diyjack/portapack/portapack_hackrf/hardware/portapack_hackrf_one/case/pp_h1_case.png

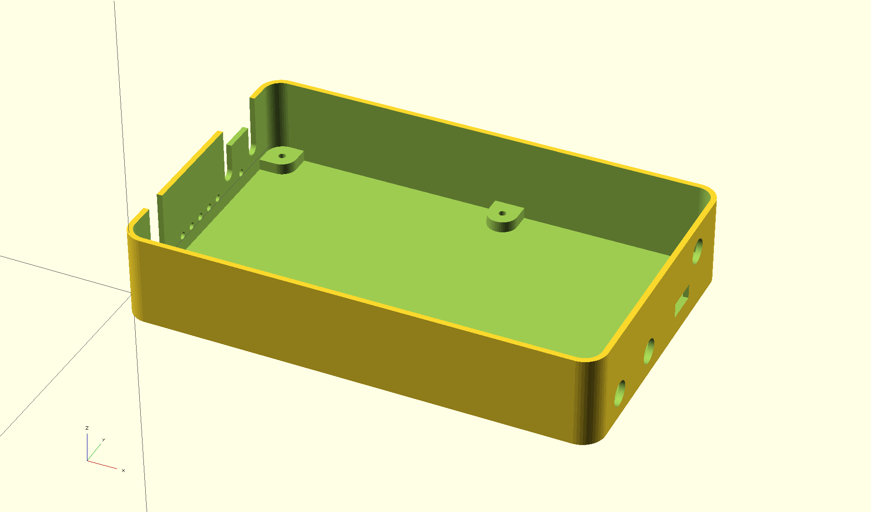
portapack_hackrf/hardware/portapack_hackrf_one/case/pp_h1_case.png
