diyjack/portapack/portapack_hackrf/hardware/portapack_hackrf_one/case/pp_h1_case.stl

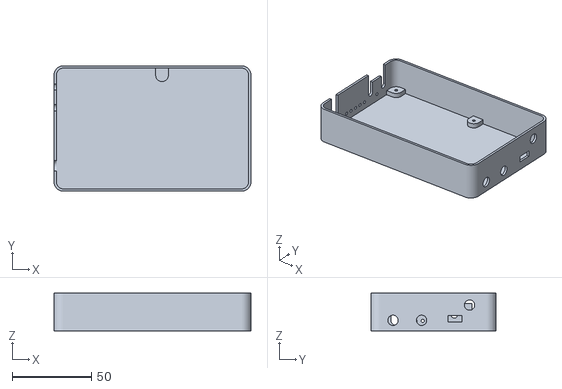
[picture p12: CAD file, 2014-07-30]
portapack_hackrf/hardware/portapack_hackrf_one/case/pp_h1_case.stl
124.0 x 79.0 x 23.7
