diyjack/portapack/portapack_hackrf/hardware/portapack_hackrf_one/portapack_hackrf_one.pdf

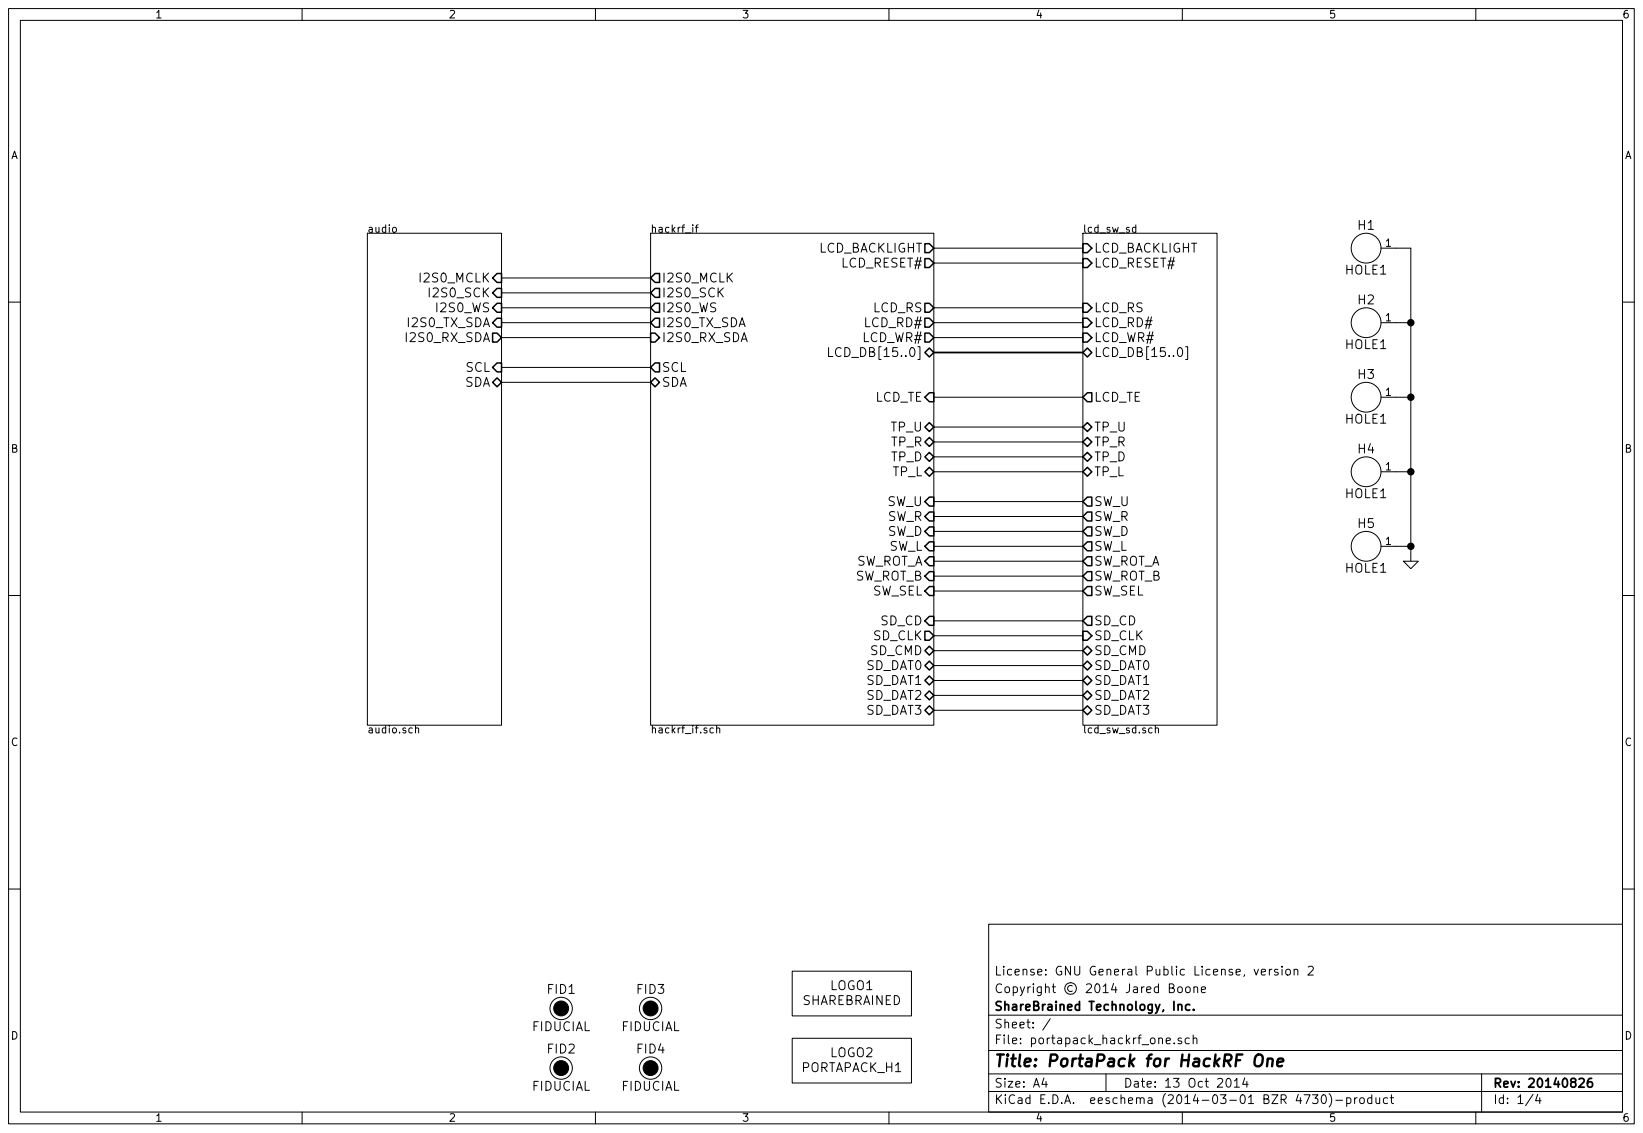
[picture p13: page 1]

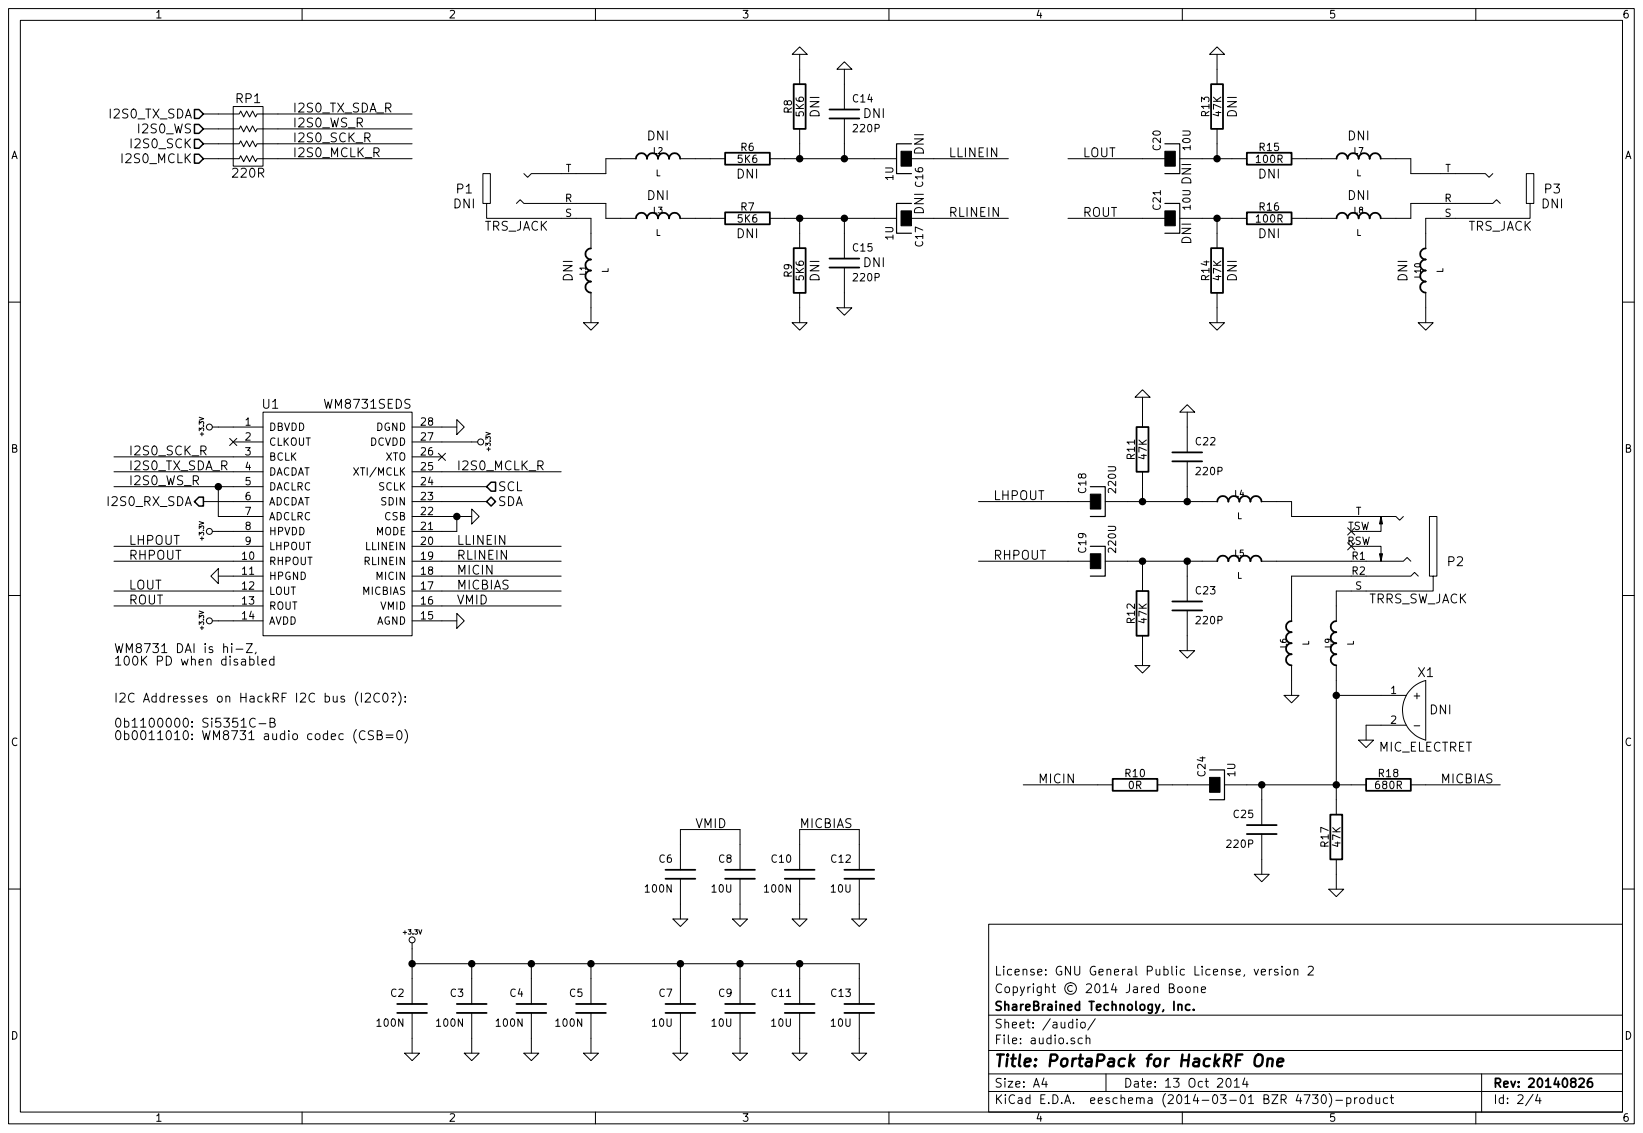
[picture p14: page 2]

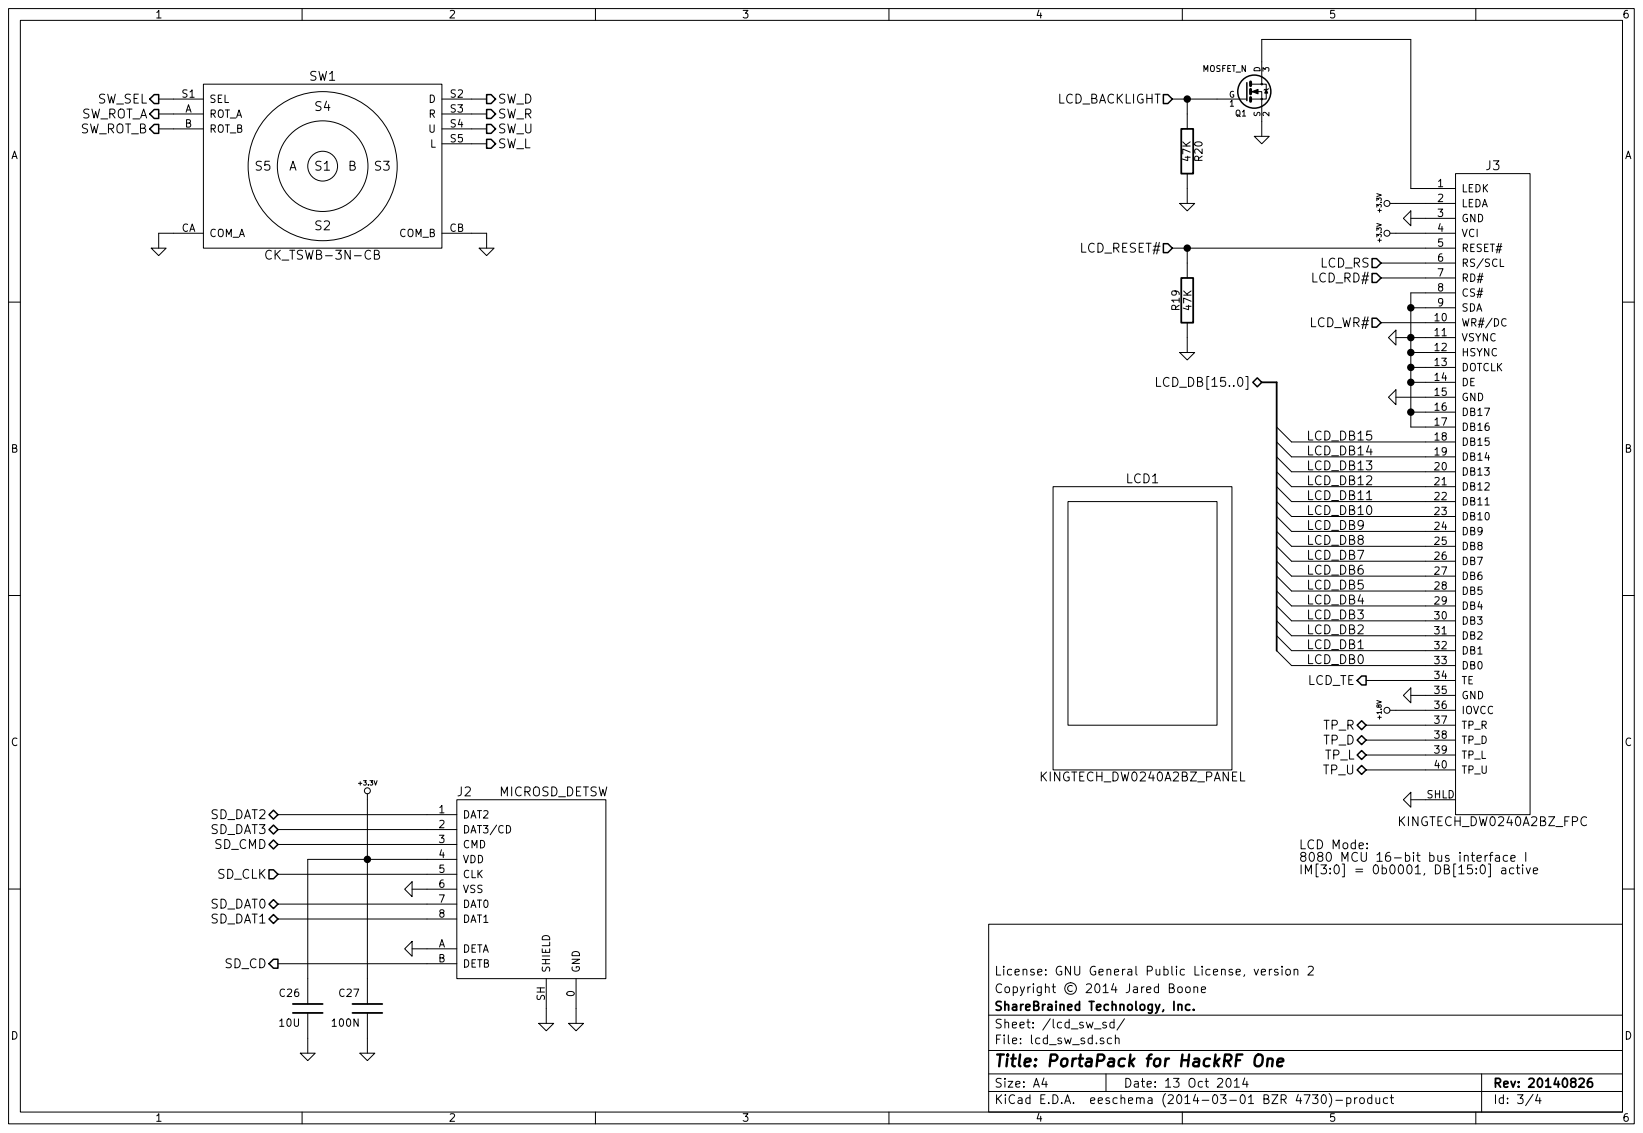
[picture p15: page 3]

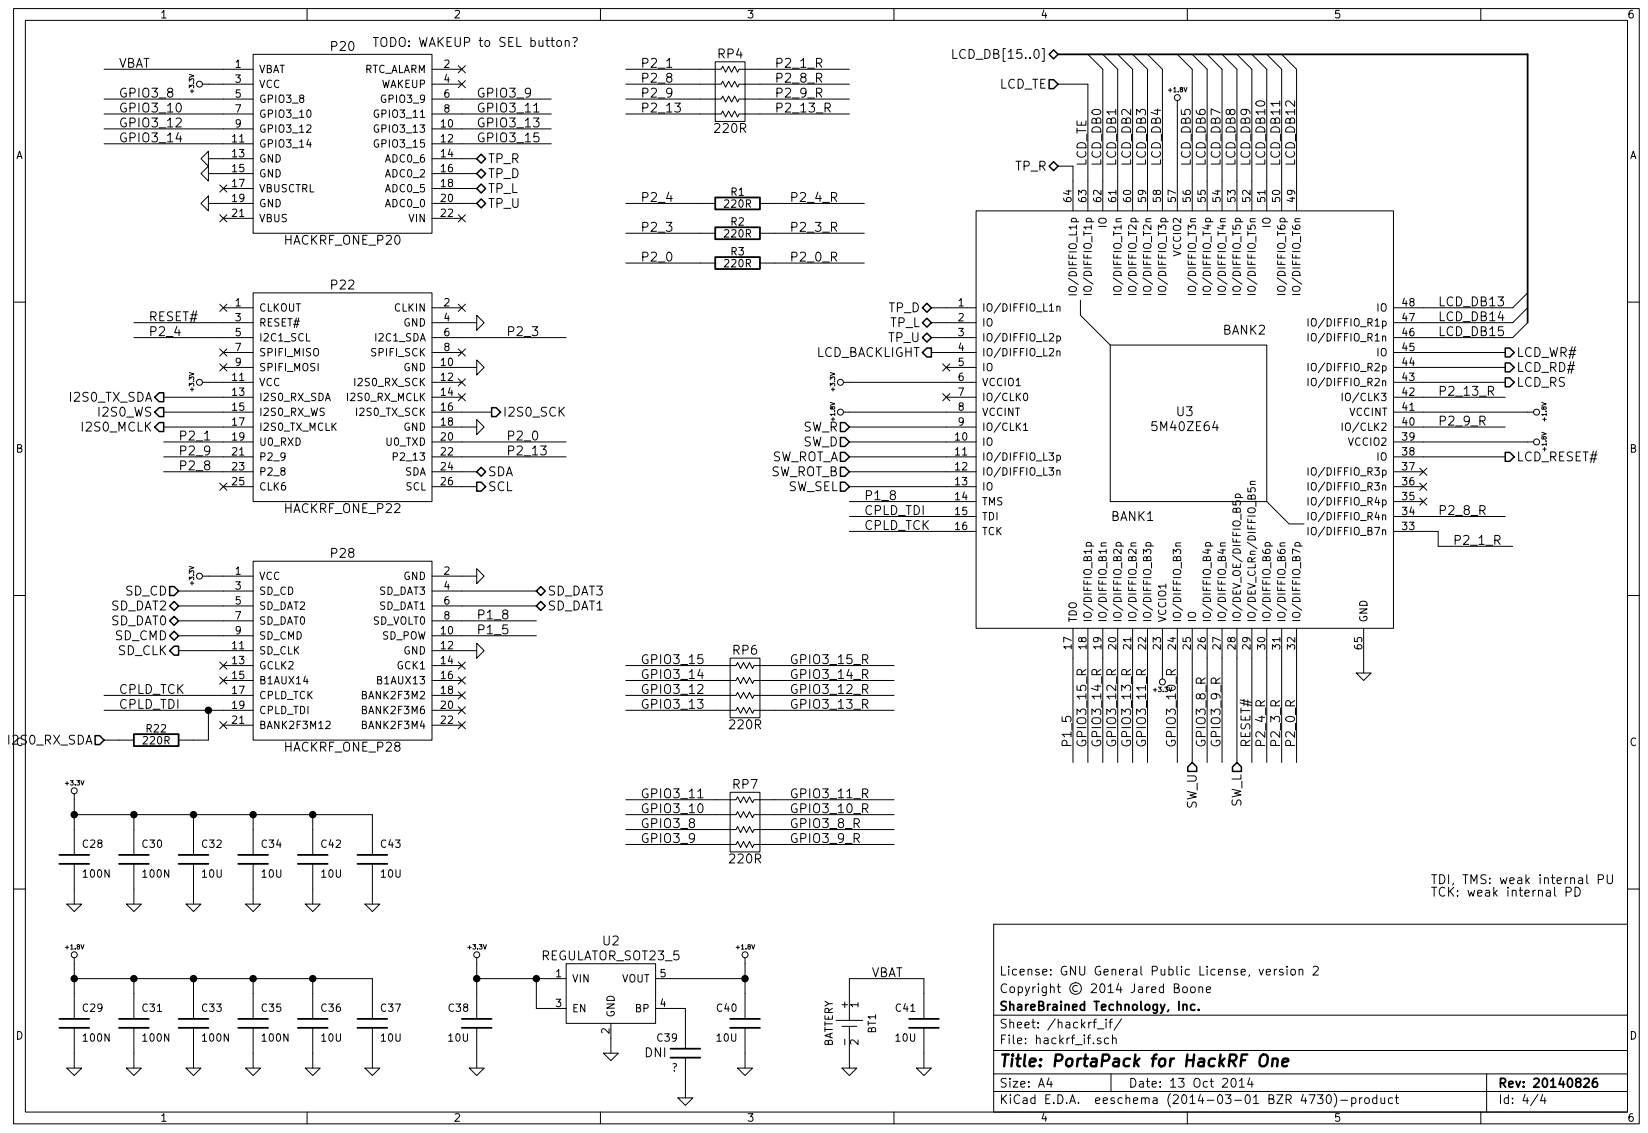
[picture p16: page 4]
