diyjack/portapack/portapack_hackrf/hardware/portapack_hackrf_one/portapack_hackrf_one.kicad_pcb

## KiCad design portapack_hackrf/hardware/portapack_hackrf_one/portapack_hackrf_one.kicad_pcb (2014-10-13)

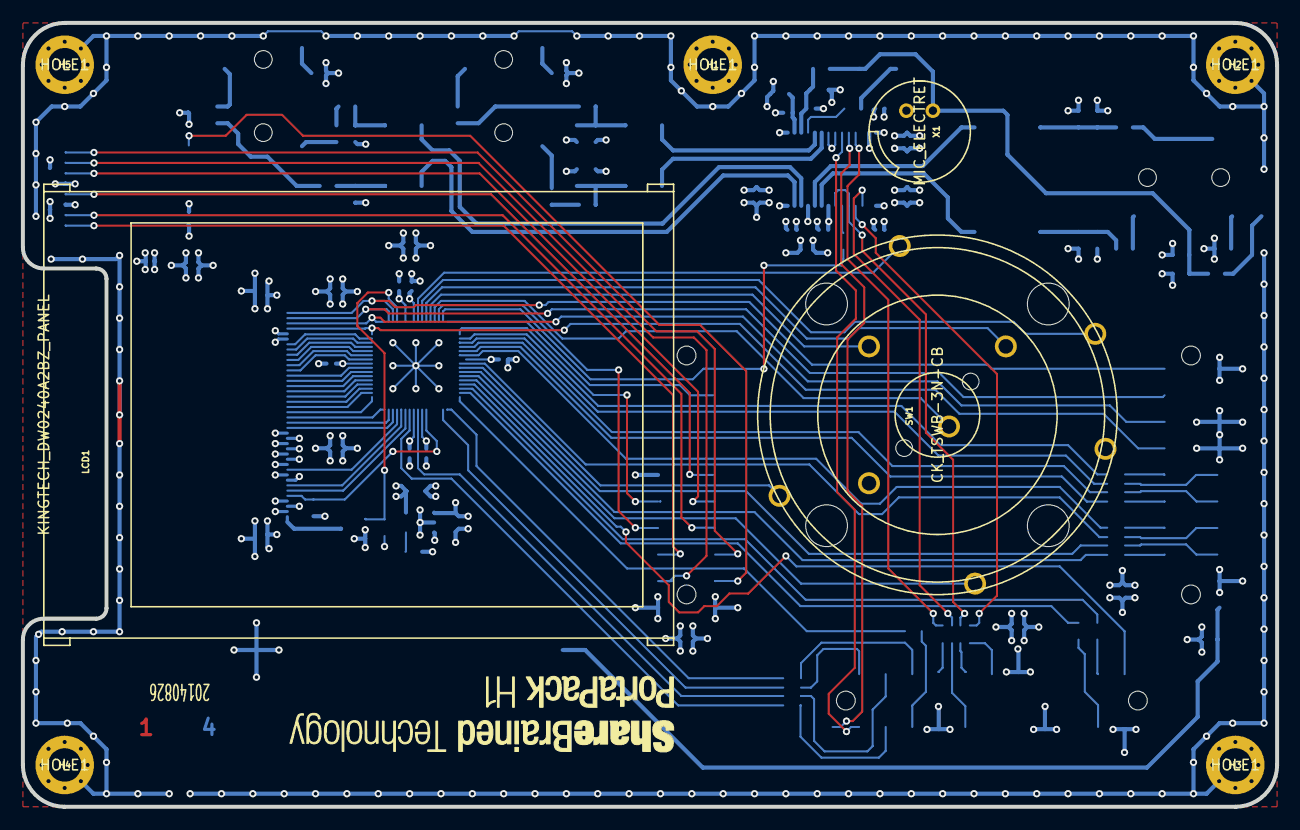
[picture p17: board portapack_hackrf_one.kicad_pcb from above]

Board: 4 copper layers, 120.0 x 75.0 mm, 102 parts (0 on the bottom side), 123 nets.

Parts:
BT1: BATTERY; MPD_BU2032SM-BT-G
C2, C3, C4, C5, C6, C10, C27, C28, C29, C30, C31, C33, C35: 100N; IPC_CAPC1005X55N
C7, C8, C9, C11, C12, C13, C26, C32, C34, C36, C37, C38, C40, C41, C42, C43: 10U; IPC_CAPC2012X140N
C14, C15, C22, C23, C25: 220P; IPC_CAPC1608X95N
C16, C17, C24: 1U; IPC_CAPAE430X540N
C18, C19: 220U; IPC_CAPAE830X620N
C20, C21: 10U; IPC_CAPAE430X540N
C39: DNI; IPC_CAPC1608X90N
FID1, FID2, FID3, FID4: FIDUCIAL; FIDUCIAL_65MIL
H1, H2, H3, H4, H5: HOLE1; HOLE_3200UM_VIAS
J2: MICROSD_DETSW; ALPS_SCHA4B0100
J3: KINGTECH_DW0240A2BZ_FPC; MOLEX_54132-40XX_LR
L1, L2, L3, L4, L5, L6, L7, L8, L9, L10: L; IPC_INDC1608X95N
LCD1: KINGTECH_DW0240A2BZ_PANEL
LOGO1: SHAREBRAINED; sharebrained_text_300
LOGO2: PORTAPACK_H1; portapack_text_300
P1, P3: TRS_JACK; CUI_SJ-3524-SMT
P2: TRRS_SW_JACK; CUI_SJ-43516-SMT
P20: HACKRF_ONE_P20; HEADER_11X2_REV_SM_254_AP
P22: HACKRF_ONE_P22; HEADER_13X2_REV_SM_254_AP
P28: HACKRF_ONE_P28; HEADER_11X2_REV_SM_254_AP
Q1: MOSFET_N; IPC_SOT95P230X110-3N
R1, R2, R3, R22: 220R; IPC_RESC1608X55N
R6, R7, R8, R9: 5K6; IPC_RESC1608X55N
R10, R11, R12, R13, R14, R17, R19, R20: 47K; IPC_RESC1608X55N
R15, R16: 100R; IPC_RESC1608X55N
R18: 680R; IPC_RESC1608X55N
RP1, RP4, RP6, RP7: 220R; IPC_RESCAXS80P160X320X60-8N
SW1: CK_TSWB-3N-CB; CK_TSWB-3N-CB222_LFS
U1: WM8731SEDS; IPC_SOP65P780X200-28N
U2: REGULATOR_SOT23_5; IPC_SOT95P280X110-5N
U3: 5M40ZE64; IPC_QFP40P900X900X120-65N
X1: MIC_ELECTRET; CUI_CMA-4544PF-W

Connections:
+1.8V: C29.1, C31.1, C33.1, C35.1, C36.1, C37.1, C40.1, J3.36, U2.5, U3.8, U3.39, U3.41, U3.57
+3.3V: C2.1, C3.1, C4.1, C5.1, C7.1, C9.1, C11.1, C13.1, C26.1, C27.1, C28.1, C30.1, C32.1, C34.1, C38.1, C42.1, C43.1, J2.4, J3.2, J3.4, P20.3, P22.11, P28.1, U1.1, U1.8, U1.14, U1.27, U2.1, U2.3, U3.6, U3.23
/audio/I2S0_MCLK: P22.17, RP1.4
/audio/I2S0_MCLK_R: RP1.5, U1.25
/audio/I2S0_RX_SDA: R22.2, U1.6
/audio/I2S0_SCK: P22.16, RP1.3
/audio/I2S0_SCK_R: RP1.6, U1.3
/audio/I2S0_TX_SDA: P22.13, RP1.1
/audio/I2S0_TX_SDA_R: RP1.8, U1.4
/audio/I2S0_WS: P22.15, RP1.2
/audio/I2S0_WS_R: RP1.7, U1.5, U1.7
/audio/LHPOUT: C18.1, U1.9
/audio/LLINEIN: C16.1, U1.20
/audio/LOUT: C20.1, U1.12
/audio/MICBIAS: C10.1, C12.1, R18.1, U1.17
/audio/MICIN: R10.2, U1.18
/audio/RHPOUT: C19.1, U1.10
/audio/RLINEIN: C17.1, U1.19
/audio/ROUT: C21.1, U1.13
/audio/SCL: P22.26, U1.24
/audio/SDA: P22.24, U1.23
/audio/VMID: C6.1, C8.1, U1.16
/hackrf_if/CPLD_TCK: P28.17, U3.16
/hackrf_if/CPLD_TDI: P28.19, R22.1, U3.15
/hackrf_if/GPIO3_8: P20.5, RP7.3
/hackrf_if/GPIO3_8_R: RP7.6, U3.26
/hackrf_if/GPIO3_9: P20.6, RP7.4
/hackrf_if/GPIO3_9_R: RP7.5, U3.27
/hackrf_if/GPIO3_10: P20.7, RP7.2
/hackrf_if/GPIO3_10_R: RP7.7, U3.24
/hackrf_if/GPIO3_11: P20.8, RP7.1
/hackrf_if/GPIO3_11_R: RP7.8, U3.22
/hackrf_if/GPIO3_12: P20.9, RP6.3
/hackrf_if/GPIO3_12_R: RP6.6, U3.20
/hackrf_if/GPIO3_13: P20.10, RP6.4
/hackrf_if/GPIO3_13_R: RP6.5, U3.21
/hackrf_if/GPIO3_14: P20.11, RP6.2
/hackrf_if/GPIO3_14_R: RP6.7, U3.19
/hackrf_if/GPIO3_15: P20.12, RP6.1
/hackrf_if/GPIO3_15_R: RP6.8, U3.18
/hackrf_if/LCD_BACKLIGHT: Q1.1, R20.2, U3.4
/hackrf_if/LCD_DB0: J3.33, U3.62
/hackrf_if/LCD_DB1: J3.32, U3.61
/hackrf_if/LCD_DB2: J3.31, U3.60
/hackrf_if/LCD_DB3: J3.30, U3.59
/hackrf_if/LCD_DB4: J3.29, U3.58
/hackrf_if/LCD_DB5: J3.28, U3.56
/hackrf_if/LCD_DB6: J3.27, U3.55
/hackrf_if/LCD_DB7: J3.26, U3.54
/hackrf_if/LCD_DB8: J3.25, U3.53
/hackrf_if/LCD_DB9: J3.24, U3.52
/hackrf_if/LCD_DB10: J3.23, U3.51
/hackrf_if/LCD_DB11: J3.22, U3.50
/hackrf_if/LCD_DB12: J3.21, U3.49
/hackrf_if/LCD_DB13: J3.20, U3.48
/hackrf_if/LCD_DB14: J3.19, U3.47
/hackrf_if/LCD_DB15: J3.18, U3.46
/hackrf_if/LCD_RD#: J3.7, U3.44
/hackrf_if/LCD_RESET#: J3.5, R19.1, U3.38
/hackrf_if/LCD_RS: J3.6, U3.43
/hackrf_if/LCD_TE: J3.34, U3.63
/hackrf_if/LCD_WR#: J3.10, U3.45
/hackrf_if/P1_5: P28.10, U3.17
/hackrf_if/P1_8: P28.8, U3.14
/hackrf_if/P2_0: P22.20, R3.2
/hackrf_if/P2_0_R: R3.1, U3.32
/hackrf_if/P2_1: P22.19, RP4.1
/hackrf_if/P2_1_R: RP4.8, U3.33
/hackrf_if/P2_3: P22.6, R2.2
/hackrf_if/P2_3_R: R2.1, U3.31
/hackrf_if/P2_4: P22.5, R1.2
/hackrf_if/P2_4_R: R1.1, U3.30
/hackrf_if/P2_8: P22.23, RP4.2
/hackrf_if/P2_8_R: RP4.7, U3.34
/hackrf_if/P2_9: P22.21, RP4.3
/hackrf_if/P2_9_R: RP4.6, U3.40
/hackrf_if/P2_13: P22.22, RP4.4
/hackrf_if/P2_13_R: RP4.5, U3.42
/hackrf_if/RESET#: P22.3, U3.29
/hackrf_if/SD_CD: J2.B, P28.3
/hackrf_if/SD_CLK: J2.5, P28.11
/hackrf_if/SD_CMD: J2.3, P28.9
/hackrf_if/SD_DAT0: J2.7, P28.7
/hackrf_if/SD_DAT1: J2.8, P28.6
/hackrf_if/SD_DAT2: J2.1, P28.5
/hackrf_if/SD_DAT3: J2.2, P28.4
/hackrf_if/SW_D: SW1.S2, U3.10
/hackrf_if/SW_L: SW1.S5, U3.28
/hackrf_if/SW_R: SW1.S3, U3.9
/hackrf_if/SW_ROT_A: SW1.A, U3.11
/hackrf_if/SW_ROT_B: SW1.B, U3.12
/hackrf_if/SW_SEL: SW1.S1, U3.13
/hackrf_if/SW_U: SW1.S4, U3.25
/hackrf_if/TP_D: J3.38, P20.16, U3.1
/hackrf_if/TP_L: J3.39, P20.18, U3.2
/hackrf_if/TP_R: J3.37, P20.14, U3.64
/hackrf_if/TP_U: J3.40, P20.20, U3.3
/hackrf_if/VBAT: BT1.1, C41.1, P20.1
GND: BT1.2, C2.2, C3.2, C4.2, C5.2, C6.2, C7.2, C8.2, C9.2, C10.2, C11.2, C12.2, C13.2, C14.1, C15.2, C22.1, C23.2, C25.2, C26.2, C27.2, C28.2, C29.2, C30.2, C31.2, C32.2, C33.2, C34.2, C35.2, C36.2, C37.2, C38.2, C39.2, C40.2, C41.2, C42.2, C43.2, H1.1, H2.1, H3.1, H4.1, H5.1, J2.0, J2.6, J2.A, J2.SH, J3.3, J3.8, J3.9, J3.11, J3.12, J3.13, J3.14, J3.15, J3.16, J3.17, J3.35, J3.SHLD, L1.2, L6.2, L10.2, P20.13, P20.15, P20.19, P22.4, P22.10, P22.18, P28.2, P28.12, Q1.2, R8.1, R9.2, R11.1, R12.2, R13.1, R14.2, R17.2, R19.2, R20.1, SW1.CA, SW1.CB, U1.11, U1.15, U1.21, U1.22, U1.28, U2.2, U3.65, X1.2
unnamed: C14.2, C16.2, R6.1, R8.2
unnamed: C15.1, C17.2, R7.1, R9.1
unnamed: C18.2, C22.2, L4.2, R11.2
unnamed: C19.2, C23.1, L5.2, R12.1
unnamed: C20.2, R13.2, R15.2
unnamed: C21.2, R14.1, R16.2
unnamed: C24.1, R10.1
unnamed: C24.2, C25.1, L9.2, R17.1, R18.2, X1.1
unnamed: C39.1, U2.4
unnamed: J3.1, Q1.3
unnamed: L1.1, P1.1
unnamed: L2.1, R6.2
unnamed: L2.2, P1.2
unnamed: L3.1, R7.2
unnamed: L3.2, P1.3
unnamed: L4.1, P2.2
unnamed: L5.1, P2.3
unnamed: L6.1, P2.4
unnamed: L7.1, P3.2
unnamed: L7.2, R15.1
unnamed: L8.1, P3.3
unnamed: L8.2, R16.1
unnamed: L9.1, P2.1
unnamed: L10.1, P3.1
