diyjack/portapack/portapack_hackrf/firmware/portapack_hackrf/cpld_data.h

static const uint16_t portapack_cpld_jtag_block_0[] = {
	0x7fff, 0xffff, 0xbffc, 0xf9e7, 0x79ff, 0xfffe, 0xaf9e, 0x7cff,
	0x7fff, 0xfbe7, 0xb3f7, 0xffff, 0x7f3f, 0x7dfb, 0xbfff, 0xffff,
	0x7fff, 0xffff, 0xbff7, 0xffff, 0x7fff, 0xffff, 0xbfff, 0xffff,
	0x7fff, 0xffff, 0xbfff, 0xffff, 0x7fff, 0xffff, 0xbfff, 0xfffe,
	0x67ff, 0xffff, 0xbfff, 0xfeff, 0x77fd, 0xff7f, 0xbfdd, 0xe7f9,
	0x733f, 0xff79, 0xb77f, 0xcccf, 0x7ff9, 0xb99f, 0xbccc, 0xcfff,
	0x7fff, 0xffff, 0xbfff, 0xffd5, 0x7fef, 0xffff, 0xbffb, 0xffff,
	0x7fff, 0xffff, 0xbfff, 0xffff, 0x7fbf, 0xffff, 0xbfff, 0xffff,
	0x7fff, 0xffff, 0xbfff, 0xffff, 0x7ffb, 0xffff, 0xbfef, 0xffff,
	0x7fff, 0xffff, 0xbff7, 0xffff, 0x7fff, 0xfffb, 0xbfff, 0xffff,
	0x6fff, 0xffff, 0xbfff, 0xffe7, 0x7fef, 0xffff, 0xbffd, 0xffff,
	0x7fff, 0xefff, 0xbfff, 0xffff, 0x7fff, 0xffff, 0xbfff, 0xfffe,
	0x7fff, 0xffff, 0xbfff, 0xfffd, 0x77ff, 0xffff, 0xbff7, 0xffff,
	0x7fff, 0xefff, 0xbfff, 0xffff, 0x7fff, 0xffff, 0xbfff, 0xfffe,
	0x6fff, 0xffff, 0xbfff, 0xff7b, 0x7fff, 0xffef, 0xbfff, 0xffff,
	0x7fff, 0xafff, 0xbfff, 0xffff, 0x7fbf, 0xffff, 0xbfff, 0xfffe,
	0x7bff, 0xffff, 0xbfff, 0xffff, 0x7fff, 0xf57f, 0xbff7, 0xdfff,
	0x77ff, 0xe7ff, 0xbfff, 0xffff, 0x7fff, 0xffff, 0xbfff, 0xfffe,
	0x7fff, 0xffff, 0xbfff, 0xffbf, 0x7fff, 0xf7ff, 0xbfff, 0xefff,
	0x7fff, 0xb7ff, 0xbfff, 0xffff, 0x7fbf, 0xffff, 0xbfff, 0xfffe,
	0x7fff, 0xffff, 0xbfff, 0xfffb, 0x7fff, 0xfb77, 0xbffb, 0xffff,
	0x77ff, 0xefff, 0xbfff, 0xffff, 0x7fff, 0xffff, 0xbfff, 0xffff,
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
	0xffff, 0xffff, 0xffff, 0xffff, 0xffff, 0xffff, 0xffff, 0xffff,
	0xffff, 0xffff, 0xffff, 0xffff, 0xffff, 0xffff, 0xffff, 0xffff,
	0xffff, 0xffff, 0xffff, 0xffff, 0xffff, 0xffff, 0xffff, 0xffff,
	0xffff, 0xffff, 0xffff, 0xffff, 0xffff, 0xffff, 0xffff, 0xffff,
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
};
