diyjack/portapack/portapack_hackrf/firmware/portapack_hackrf/lcd_color_lut.cpp

#include "lcd_color_lut.h"

const lcd_color_t spectrum_rgb2_lut[] = {
	LCD_COLOR(  0,  0,128),
	LCD_COLOR(  0,  0,132),
	LCD_COLOR(  0,  0,136),
	LCD_COLOR(  0,  0,140),
	LCD_COLOR(  0,  0,144),
	LCD_COLOR(  0,  0,148),
	LCD_COLOR(  0,  0,152),
	LCD_COLOR(  0,  0,156),
	LCD_COLOR(  0,  0,160),
	LCD_COLOR(  0,  0,164),
	LCD_COLOR(  0,  0,168),
	LCD_COLOR(  0,  0,172),
	LCD_COLOR(  0,  0,176),
	LCD_COLOR(  0,  0,180),
	LCD_COLOR(  0,  0,184),
	LCD_COLOR(  0,  0,188),
	LCD_COLOR(  0,  0,192),
	LCD_COLOR(  0,  0,195),
	LCD_COLOR(  0,  0,199),
	LCD_COLOR(  0,  0,203),
	LCD_COLOR(  0,  0,207),
	LCD_COLOR(  0,  0,211),
	LCD_COLOR(  0,  0,215),
	LCD_COLOR(  0,  0,219),
	LCD_COLOR(  0,  0,223),
	LCD_COLOR(  0,  0,227),
	LCD_COLOR(  0,  0,231),
	LCD_COLOR(  0,  0,235),
	LCD_COLOR(  0,  0,239),
	LCD_COLOR(  0,  0,243),
	LCD_COLOR(  0,  0,247),
	LCD_COLOR(  0,  0,251),
	LCD_COLOR(  0,  0,255),
	LCD_COLOR(  0,  4,255),
	LCD_COLOR(  0,  8,255),
	LCD_COLOR(  0, 12,255),
	LCD_COLOR(  0, 16,255),
	LCD_COLOR(  0, 20,255),
	LCD_COLOR(  0, 24,255),
	LCD_COLOR(  0, 28,255),
	LCD_COLOR(  0, 32,255),
	LCD_COLOR(  0, 36,255),
	LCD_COLOR(  0, 40,255),
	LCD_COLOR(  0, 44,255),
	LCD_COLOR(  0, 48,255),
	LCD_COLOR(  0, 52,255),
	LCD_COLOR(  0, 56,255),
	LCD_COLOR(  0, 60,255),
	LCD_COLOR(  0, 64,255),
	LCD_COLOR(  0, 68,255),
	LCD_COLOR(  0, 72,255),
	LCD_COLOR(  0, 76,255),
	LCD_COLOR(  0, 80,255),
	LCD_COLOR(  0, 84,255),
	LCD_COLOR(  0, 88,255),
	LCD_COLOR(  0, 92,255),
	LCD_COLOR(  0, 96,255),
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
	LCD_COLOR(114,141,  0),
	LCD_COLOR(117,138,  0),
	LCD_COLOR(120,135,  0),
	LCD_COLOR(123,132,  0),
	LCD_COLOR(126,129,  0),
	LCD_COLOR(129,126,  0),
	LCD_COLOR(132,123,  0),
	LCD_COLOR(135,120,  0),
	LCD_COLOR(138,117,  0),
	LCD_COLOR(141,114,  0),
	LCD_COLOR(144,111,  0),
	LCD_COLOR(147,108,  0),
	LCD_COLOR(150,105,  0),
	LCD_COLOR(153,102,  0),
	LCD_COLOR(156, 99,  0),
	LCD_COLOR(159, 96,  0),
	LCD_COLOR(162, 93,  0),
	LCD_COLOR(165, 90,  0),
	LCD_COLOR(168, 87,  0),
	LCD_COLOR(171, 84,  0),
	LCD_COLOR(174, 81,  0),
	LCD_COLOR(177, 78,  0),
	LCD_COLOR(180, 75,  0),
	LCD_COLOR(183, 72,  0),
	LCD_COLOR(186, 69,  0),
	LCD_COLOR(189, 66,  0),
	LCD_COLOR(192, 63,  0),
	LCD_COLOR(195, 60,  0),
	LCD_COLOR(198, 57,  0),
	LCD_COLOR(201, 54,  0),
	LCD_COLOR(204, 51,  0),
	LCD_COLOR(207, 48,  0),
	LCD_COLOR(210, 45,  0),
	LCD_COLOR(213, 42,  0),
	LCD_COLOR(216, 39,  0),
	LCD_COLOR(219, 36,  0),
	LCD_COLOR(222, 33,  0),
	LCD_COLOR(225, 30,  0),
	LCD_COLOR(228, 27,  0),
	LCD_COLOR(231, 24,  0),
	LCD_COLOR(234, 21,  0),
	LCD_COLOR(237, 18,  0),
	LCD_COLOR(240, 15,  0),
	LCD_COLOR(243, 12,  0),
	LCD_COLOR(246,  9,  0),
	LCD_COLOR(249,  6,  0),
	LCD_COLOR(252,  3,  0),
	LCD_COLOR(255,  0,  0),
};
