diyjack/portapack/portapack_hackrf/firmware/portapack_hackrf/window.h

/*
 * Copyright (C) 2013 Jared Boone, ShareBrained Technology, Inc.
 *
 * This file is part of PortaPack.
 *
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
 * You should have received a copy of the GNU General Public License
 * along with this program; see the file COPYING.  If not, write to
 * the Free Software Foundation, Inc., 51 Franklin Street,
 * Boston, MA 02110-1301, USA.
 */

#pragma once

#ifndef __WINDOW_H__
#define __WINDOW_H__

const float window[256] = {
	0.0000000000f,
	0.0001517740f,
	0.0006070039f,
	0.0013654133f,
	0.0024265418f,
	0.0037897452f,
	0.0054541958f,
	0.0074188833f,
	0.0096826148f,
	0.0122440160f,
	0.0151015320f,
	0.0182534279f,
	0.0216977902f,
	0.0254325280f,
	0.0294553737f,
	0.0337638853f,
	0.0383554469f,
	0.0432272712f,
	0.0483764003f,
	0.0537997084f,
	0.0594939029f,
	0.0654555268f,
	0.0716809611f,
	0.0781664261f,
	0.0849079846f,
	0.0919015438f,
	0.0991428580f,
	0.1066275310f,
	0.1143510188f,
	0.1223086326f,
	0.1304955414f,
	0.1389067748f,
	0.1475372265f,
	0.1563816570f,
	0.1654346968f,
	0.1746908499f,
	0.1841444969f,
	0.1937898985f,
	0.2036211990f,
	0.2136324300f,
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
};

#endif/*__WINDOW_H__*/
