diyjack/portapack/(commit log)

2014-06-14 Enable HackRF One RF power at start-up.
2014-06-14 Remove JAWBREAKER-conditional code, expecting to support older HackRFs with new PCB design and common code.
2014-06-14 Move WM8731 I2C address declaration.
2014-06-14 PortaPack I2C "abstraction".
2014-06-28 CPLD configuration for 20140512 prototype.
2014-07-01 Major revision 20140701 of PortaPack H1 PCB design for second prototype. Slight changes to signal mapping to CPLD. Added lots of signal integrity and EMC tweaks, including series resistor termination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
    [audio.sch, hackrf_if.sch, lcd_sw_sd.sch, portapack_hackrf_one.kicad_pcb, portapack_hackrf_one.sch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]
2014-07-04 Add part info for FFC connector.
    [lcd_sw_sd.sch]
2014-07-04 Invert LCD_BACKLIGHT to work with high side P-channel MOSFET circuit.
    [top.vhd]
2014-07-04 Fix syntax error in CODEC_ENABLEX.
    [top.vhd]
2014-07-04 CPLD: Change pin mappings to match 20140701 board revision. CPLD: Change voltage levels to support 1.8V LCD interface. CPLD: Turn off PCI clamps on pins with VCCIO=1.8V but 3.3V CMOS inputs. Turn off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
    [portapack_hackrf_one_cpld.qsf]
2014-07-08 Updated component manufacturer/part numbers and values to reflect latest build.
    [audio.sch, hackrf_if.sch, lcd_sw_sd.sch]
2014-07-08 Remove separate CODEC_VDD, replace with 3.3V. Let KiCad rename all the power nets.
    [audio.sch, hackrf_if.sch, lcd_sw_sd.sch, portapack_hackrf_one.sch]
2014-07-08 Remove LCD backlight current resistor.
    [lcd_sw_sd.sch]
2014-07-08 Change SD card to SCHA4B0100, since SCHA4B0400 is temporarily unavailable.
    [lcd_sw_sd.sch]
2014-07-15 Set microphone gain to -1.1dB with 47K resistor.
    [audio.sch]
2014-07-15 Changed C&K navigation switch from black to white part number.
    [lcd_sw_sd.sch]
2014-07-17 Changed LCD backlight switch back to N-type MOSFET, changed CPLD pin.
    [hackrf_if.sch, lcd_sw_sd.sch, portapack_hackrf_one.sch]
2014-07-17 Updated schematic revision to 20140717.
    [audio.sch, hackrf_if.sch, lcd_sw_sd.sch, portapack_hackrf_one.sch]
2014-07-17 Update schematic PDF, netlist, component footprints, PCB from schematic changes.
    [portapack_hackrf_one.kicad_pcb]
2014-07-20 Extract M4 core handlers into separate .c/.h files. TODO: There's a lot of leakage from portapack.c that needs to be addressed.
    [ipc_m4_server.h, portapack.h]
2014-07-20 Hide details of IPC implementation (kfifo, raising interrupt on other core) behind new ipc_channel_write() function.
2014-07-20 Rename UI function to avoid name collision with soon-to-be-renamed baseband function.
    [lcd_loop.c]
2014-07-20 Move responsibility for tracking DSP block output sample count to individual functions which decimate.
2014-07-21 Fix missing pointer increment when scaling processed baseband samples to prevent saturation.
2014-07-21 Rework gain structure in NBFM and AM RX processing chains. Switch from right shifts (not guaranteed to be arithmetic in C for signed values) to divide-by-two operations.
2014-07-24 Encoder: Move code to M0, poll instead of interrupt because interrupts were catching mechanical switch noise and causing erratic behavior. TODO: Poll with a timer instead of from LCD drawing loop.
    [lcd_loop.c, portapack_driver.h]
2014-07-25 Envelope: HACK! Add small constant to avoid NaNs.
    [envelope.h]
2014-07-25 Change type of packet data to bytes, kill endianness problems.
    [ipc_m0.h, ipc_m0_client.h, packet_builder.h]
2014-07-25 UI: Wrap displaying of M4 CPU metrics in a #define so I can switch it on easily. Still ugly...
2014-07-25 Capture only timestamps in baseband handlers. Extract common code into baseband interrupt.
2014-07-26 RX TPMS: Removed symbol integrator/filter
    Filter was too narrow and failing to pick up transmissions where there was a significant (but reasonable) carrier offset.
    [rx_tpms.c]
2014-07-27 Decimate: Correct scaling
    Scaling of a couple of real decimators relied on right shifts -- behavior is unpredictable in C99. Fix by doing proper power-of-two divide.
2014-07-29 TPMS: Adjust sample rate constant notation.
2014-07-29 More demodulator refactoring.
    Moved filter taps into filters.c.
    Moved FM narrowband and AM demodulators into separate files.
2014-07-29 Encoder: Move initialization from M4 to M0.
2014-07-29 Baseband: Move SGPIO DMA ack to end of interrupt.
    This prevents locking up the baseband at 100% CPU utilization if the baseband handler does not complete in one baseband frame. Instead a baseband frame is dropped.
2014-07-29 Specan: Track performance in baseband handler.
2014-07-30 Case: Initial PortaPack H1 bottom case.
    [pp_h1_case.scad, pp_h1_case.stl]
2014-07-30 PCB: PortaPack H1 20140717_0930
    [portapack_hackrf_one-paste_bot.gbp, portapack_hackrf_one-paste_top.gtp, portapack_hackrf_one_copper_1_top.gtl, portapack_hackrf_one_copper_4_bot.gbl, portapack_hackrf_one_drill.xln, portapack_hackrf_one_edge.gko, portapack_hackrf_one_mask_bot.gbs, portapack_hackrf_one_mask_top.gts]
2014-07-31 Specan: Improve sampling rate, decimation, filter bandwidth.
2014-07-31 UI: Fix dumb overflow when displaying frequencies >= 2^31.
    [lcd_loop.c]
2014-07-31 Encoder: Remove LED indicators for quadrature state.
2014-07-31 RTC: Interrupt support.
2014-07-31 UI: Add RTC interrupt to update date/time when second increments.
2014-07-31 Add RI timer API.
2014-07-31 UI: Use RI timer to create 1kHz encoder update rate.
2014-07-31 UI: Use RTC command sent from interrupt to update on-screen time.
2014-08-01 ADC: Reminder to move #defines from lcd_touch code to libopencm3.
2014-08-12 CPLD: Change switch inputs to Schmitt to reduce noise (maybe?).
    [portapack_hackrf_one_cpld.qsf]
2014-08-19 PCB: Change fp-lib-table for new repo/directory name.
2014-08-19 PCB: Footprint and trace changes to add SMT header alignment pins.
    Also removed fills to keep commit/repo size down.
    [portapack_hackrf_one.kicad_pcb]
2014-08-20 UI: Reset console when switching receiver modes.
    [lcd_loop.c]
2014-08-21 TPMS: Simplify half-band/translation filtering.
2014-08-21 TPMS: Eliminate sqrtf, floats computing filter power difference.
2014-08-21 UI: Fix SDIO call return variable types.
    [lcd_loop.c]
2014-08-22 Clean up a bunch of sloppy type casting.
    [lcd_loop.c]
2014-08-24 FIFO: Switch to C++ implementation.
2014-08-24 Remove linux_stuff.h, add missing bits to portapack.h.
    [lcd_loop.cpp, lcd_touch.cpp, packet_builder.cpp, portapack.cpp, portapack.h, rssi.cpp]
2014-08-24 Fix M4 command handler array indices.
    [ipc_m4_server.cpp]
2014-08-24 Fix #include for __RBIT().
    [specan.cpp]
2014-08-24 Replace array of pointers with std::vector.
    [lcd_loop.cpp]
2014-08-25 UI: Clean up of switch handling.
2014-08-25 Remove blink(), which might reappear in the LED API?
2014-08-26 PCB: Update header components.
2014-08-26 PCB: Segmented CPLD paste aperture.
    [portapack_hackrf_one.kicad_pcb]
2014-08-26 UI: Add ui_widget_t flags to selectively disable focus behavior.
    [portapack_hackrf_one_copper_1_top.gtl, portapack_hackrf_one_copper_4_bot.gbl, portapack_hackrf_one_drill.xln, portapack_hackrf_one_drill_npth.xln, portapack_hackrf_one_edge.gko, portapack_hackrf_one_mask_bot.gbs, portapack_hackrf_one_mask_top.gts, portapack_hackrf_one_paste_bot.gbp]
2014-08-30 SDIO: Use interrupt clear function.
2014-08-30 SDIO: Use two clock speeds and function to switch.
2014-08-30 SDIO: Add missing sdio_error_t values.
    [sdio.h]
2014-08-30 SDIO: Enable low-power clock mode.
2014-08-30 Encoder: Ditch the interrupt-based code, it worked terribly.
2014-08-31 RTC: Move PPS interrupt to M4, remove IPC M0 client from M0 binary.
2014-09-08 Decimate: Add 8:1 complex FIR filter.
2014-09-08 RSSI: Track peak value.
2014-09-08 UI: Change RSSI, CPU field rendering order to fix LCD tearing.
    [lcd_loop.cpp]
2014-09-15 PCB: Hand-segment CPLD thermal pad solder paste aperture.
    [portapack_hackrf_one-paste_bot.gbp]
2014-10-11 Update schematic date to reflect final PCB design.
    [audio.sch, hackrf_if.sch, lcd_sw_sd.sch, portapack_hackrf_one.sch]
2014-10-13 Disable reset of all peripherals at boot, until SPIFI can be initialized from scratch.
    [main.cpp]
2014-10-13 PCB: Set drill/place origin to top-left corner of PCB.
    [portapack_hackrf_one.kicad_pcb]
2014-10-13 Minor update to BOM, component values, DNI status in schematic.
    [audio.sch, hackrf_if.sch, lcd_sw_sd.sch, portapack_hackrf_one.sch]
2014-10-13 PCB: Mark several footprints with holes as SMT for BOM/centroid output.
    [portapack_hackrf_one.kicad_pcb]
2014-10-14 CPLD: Change for latest PCB LCD backlight control.
2014-10-21 Add GCC fix to get rid of extra sections and slim down image.
    [lcd_loop.cpp, main.cpp]
2014-10-21 Another GCC fix for missing __dso_handle symbol.
    [lcd_loop.cpp]
