diyjack/portapack/(notices)

Notices in the files:
portapack_hackrf/hardware/portapack_hackrf_one/portapack_hackrf_one.sch:
Copyright © 2014 Jared Boone
License: GNU General Public License, version 2
